FSAE-Minutemen-Racing/minutemen-racing/(commit log)

2026-02-27 Change RPM pin to working pin
2026-03-04 GNSS Script on Arduino Framework
2026-03-04 Adding GNSS PIO Project
    Tested on Teensy4.1, uses Arduino framework
2026-05-06 battery voltage sensing
2026-05-06 adjust battery sensing
2026-05-06 average battery readings
2026-07-06 Read GNSS 15 Click over I2C in telemetry
    Switch the GPS from Serial1 (shared with the dashboard screen link) to
    I2C on the Qwiic connector (Wire1). The Teseo-VIC3DA streams NMEA over
    I2C at address 0x3A with 0xFF filler bytes; poll it each loop and feed
    TinyGPSPlus. Send real lat/lng in the /data response instead of the
    0,0 placeholder.
2026-07-06 Track neutral as its own state in senseGear()
    Neutral used to alias to gear = 1 internally, so the down-shift guard
    (gear > 1) rejected paddling down from neutral and an up-shift jumped
    straight to 2nd, making 1st unreachable via the paddles. Track neutral
    with an explicit flag so a down-shift from neutral selects 1st and an
    up-shift selects 2nd, matching the 1-N-2-3-4-5 sequential box.
    Closes #7
2026-07-06 Correct gearbox pattern comment: 2004 Yamaha R6 is a 6-speed (1-N-2-3-4-5-6)
    [sensors.hpp]
2026-07-06 Guard calculateRPM() against divide-by-zero before first pulse
    During the first ~500 ms after boot, micros() is still small so the
    staleness guard is false, and pulseInterval is still 0, causing a
    60000000UL / 0 division. Return 0 explicitly when no pulse has been
    measured yet.
    Fixes #5
    [sensors.hpp]
2026-07-06 Remove dead scaffolding files from GNSS/
    Four files under GNSS/ are not compiled into the firmware and add
    confusion about which code is live:
    - GNSS/include/gps.h, GNSS/include/sensors.h — headers never #included by
    GNSS/src/main.ino (which does its own inline GPS/sensor handling)
    - GNSS/text.txt — empty (single newline)
    - GNSS/platformio - Copy.ini — byte-identical stray duplicate of platformio.ini
    Note: telemetry/include/gps.hpp, also listed in the issue, was rewritten in
    2f7ef69 into a live I2C GNSS driver (now #included by main.ino and
    server.hpp) and is intentionally kept.
    Fixes #14
2026-07-06 Align web RPM full-scale with dash and fix stale poll comment
    The web gauge saturated at 8000 RPM while the in-car dash (dashboard.ino)
    scales its RPM bar to 16000, so the two displays disagreed about full
    scale. Standardize the web gauge on 16000 (the 2004 R6 redline the dash
    already uses); 8000 was well below the engine's operating range.
    Also correct the polling comment from 200ms to 500ms to match the actual
    setInterval(getData, 500).
    Fixes #15
2026-07-09 Fix getSpeed(): add 6th gear, correct ratios, use full drivetrain formula
    RATIO_2-RATIO_5 were verbatim 2004 YZF-R6 internal gearbox ratios, not
    team-derived in/rev values as assumed in issue #21; RATIO_1 (2.401) was
    a transcription error (spec 37/13 = 2.846). Added RATIO_6 (26/24 =
    1.083) from the same spec sheet and a case 6, so 6th gear no longer
    reads the -0.5 sentinel.
    The old formula (RPM * gear_ratio / 1056) treated dimensionless
    reductions as in/rev, so speed dropped on upshift and read ~3-4x low.
    Now: RPM * tire_circumference / (primary * gear * final * 1056).
    Final drive (stock 48/16) and tire circumference (18 in OD) are
    commented placeholders until the team confirms MR19's real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
    [sensors.hpp]
2026-07-09 Add hysteresis to battery warning to stop chatter near threshold
    The BATT light used a single 12.2 V threshold for both edges, so ADC
    noise around that value could flip the warning every update cycle.
    Turn on below 12.0 V and off only above 12.4 V (band values provisional
    per issue #11).
    Fixes #11
    [screen_control.hpp]
2026-07-09 Resend all warning light states every update cycle
    A dropped serial byte or display reboot could leave a warning light
    stale indefinitely, since states were only sent on transitions. Resend
    all four states each 200 ms cycle so the dash self-corrects.
    [screen_control.hpp]
2026-07-09 Cross-check dead-reckoned gear against RPM/GPS-speed ratio
    senseGear() counts paddle presses, so a missed or failed shift desyncs
    the displayed gear (and the speed derived from it) until the car
    returns to neutral. While the engine is coupled to the wheels, the
    ratio of RPM to GPS ground speed identifies the real gear, so once per
    GPS fix we compare it against the tracked gear and resync after three
    consecutive fixes name the same different gear.
    The check gates on the neutral switch, mid-shift state, and a minimum
    speed, and does nothing when no gear ratio matches within tolerance
    (clutch in, coasting, or uncalibrated drivetrain constants), so bad
    calibration fails safe. Final drive and ti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
    [main.ino, sensors.hpp]
2026-07-09 Bound telemetry HTTP handler so a client cannot stall loop()
    runServer() busy-waited on client.connected() with no deadline and only
    broke out on a line containing 'GET /data', so a silent client, any
    other request path (a browser fetching / or /favicon.ico), or a
    half-open TCP connection stalled gear sensing, the dashboard, and the
    lap timer indefinitely. The request String also grew without bound.
    Read only the request line, under a 250 ms deadline and a 128-byte cap,
    and answer unknown paths with 404 so well-behaved clients close
    promptly.
    Fixes #3
2026-07-10 Dedupe drivetrain constants against develop after #28
    The merge of develop brought in the same PRIMARY_RATIO / FINAL_DRIVE_RATIO /
    TIRE_CIRCUMFERENCE_IN defines this branch added independently, and git kept
    both copies without conflict. Drop this branch's copy and build
    GEARBOX_RATIOS from the shared RATIO_1..6 defines so the pending sprocket /
    tire calibration only has to be edited in one place.
2026-07-10 Rework runServer() into a non-blocking state machine
    The HTTP handler no longer waits inside runServer(): the accepted
    client, partial request line, and accept timestamp persist as static
    state across loop() iterations, and each call consumes only bytes the
    modem has already buffered. The 250 ms deadline and 128-byte request
    line cap from issue #3 carry across iterations with the same drop
    semantics, so a slow, silent, or half-open client can no longer freeze
    gear sensing or drift the lap timer while being waited out.
    The /data and 404 responses now go out as one buffered write instead
    of ~12 print() calls, each of which was a separate round-trip to the
    ESP32-S3 co-processor.
    Closes #27
    C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
2026-07-18 Redesign driver screen around five values with converging shift indicator
    The old screen gave lap timer, TPS, g-force, and GPS speed the same
    visual weight as the values a driver actually needs, and the RPM slider
    was hard to read at speed. Rebuild ui_Driver_Mode by hand (dropping the
    SquareLine export) as: gear huge in the center, speed and RPM beside
    it, coolant and battery voltage in the bottom corners, warning lights
    as a dim 2x2 cluster that lights up as colored pills.
    The RPM slider becomes a shift indicator: two bars fill from the outer
    edges and converge on a center mark exactly at DASH_RPM_SHIFT, turning
    green -> yellow -> red, and an LVGL-timer-driven SHIFT banner flashes
    at ~11 H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
    [dashboard.ino, ui_Driver_Mode.c, ui_Driver_Mode.h]
2026-07-18 Calibrate final drive ratio and tire circumference from on-car measurement
    Measured 2026-07-18: final drive 3.48, tire OD 20.5 in (circumference
    64.4 in). Replaces the stock-R6 / estimated placeholders from #28 and
    removes the now-stale 'inert while uncalibrated' comments — the gear
    cross-check and getSpeed() are live from this commit.
    [sensors.hpp]
2026-07-18 Guard gear cross-check against GPS speed lag under acceleration
    GPS speed lags true speed by the receiver's fix latency, so under hard
    acceleration the observed RPM/mph ratio is biased toward a lower gear —
    long enough during an accel run to fake 3 agreeing fixes and force a
    wrong resync. Skip samples whenever speed moved more than 3 mph since
    the previous fix.
    Also reset the candidate gear (not just the agreement count) on gated
    samples, and correct the tolerance comment: 5th/6th differ by 9.9%, not
    >=10%, so their bands overlap slightly and nearest-match decides.
    [sensors.hpp]
2026-07-18 Add host-side scenario tests for the gear cross-check
    Stubs the Arduino surface sensors.hpp touches and includes the header
    unmodified, so the resync logic runs on the host with no hardware or
    PlatformIO. Covers: ratio-to-gear identification for all six gears,
    no-match rejection, missed-upshift recovery after exactly 3 agreeing
    fixes, gating on neutral/mid-shift/low-speed/acceleration, stale-neutral
    correction, and agreement leaving the tracked gear alone.
2026-07-18 Improve dashboard serial throughput (#39)
    Raise the telemetry-to-dashboard serial rate, parse dashboard commands without blocking on partial lines, and batch changed dashboard updates with periodic warning resends.
    Avoid repeated heap allocation in GPS/data responses and reuse a single RPM sample for speed, dashboard, and gear cross-check logic.
    Closes #38
    Refs #4
    [dashboard.ino, gps.hpp, main.ino, screen_control.hpp, sensors.hpp, ui_Driver_Mode.c, ui_Driver_Mode.h]
2026-07-18 Stop sending TPS and lap timer to the redesigned dash (#36)
    PR #32 removed the TPS and lap-timer widgets from the driver screen, so
    the dash now ignores the 'T' and 'L' serial commands. Drop the TPS send
    from updateDashboard() and delete incrementLaptimer() entirely — it was
    dead traffic on the 9600-baud dash link.
    Closes #35
    Refs #10
    [main.ino, screen_control.hpp]
2026-07-18 Clean up telemetry code: deduplicate, drop dead code, tidy
    - sensors.hpp: replace the hand-expanded SPEED_MPH_PER_RPM table with the
    RPM_PER_MPH macro so the drivetrain math has one source of truth; merge
    the duplicated up/down shift branches in senseGear(); drop the unused
    getSpeed(gear) overload; rename inputPin to rpm_pulse_pin and group pins
    - gps.hpp: remove unused String getGPSData(); factor the copy-pasted
    lat/lng fixed-point formatting into formatCoord()
    - screen_control.hpp: remove dead changeGear() and warning_lights()
    (the latter bypassed warning_state[], so resend would undo it)
    - kline.h: fix requestReponsePair typo, use memcmp for response checks,
    rename global buff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
    [gps.hpp, kline.h, main.ino, screen_control.hpp, sensors.hpp]
2026-07-18 Remove web server and TPS/MAP/AFR sensing from telemetry (#42)
    * Remove web server and TPS/MAP/AFR sensing (#41)
    The WiFi web server was the only remaining consumer of the TPS, MAP,
    and AFR analog channels (the dashboard stopped receiving TPS in #36),
    so all four features come out together:
    - Delete server.hpp (WiFi AP, HTTP handler) and its calls in main.ino
    - Drop the Sensors enum and readSensors(); loop() calls calculateRPM()
    directly
    - Drop formatGPSData()/formatCoord() from gps.hpp — only the server
    response used them
    RPM, gear sensing, the gear cross-check, GPS polling, and dashboard
    serial output are unchanged. Flash 63,008 -> 46,356 bytes, RAM
    8,924 -> 6,664 bytes (WiFiS3 no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
2026-07-19 Remove GNSS/ Teensy bench-test folder
    GNSS/ was a Teensy 4.1 bench-test project; the UNO R4 telemetry unit is
    the board on the car. Nothing in it is useful to telemetry: main.ino is
    a SoftwareSerial NMEA echo test superseded by the live I2C Teseo driver
    in telemetry/include/gps.hpp, and its kline.h is a stale pre-refactor
    copy of telemetry/include/kline.h that GNSS's own main.ino never even
    included. Drop the folder and its README/CONTRIBUTING references.
    Closes #16
2026-07-26 Fix neutral logic and random gear changes
    [sensors.hpp]
